brettdaman/ledstrip-night-lamp/electrics_wiring.jpg

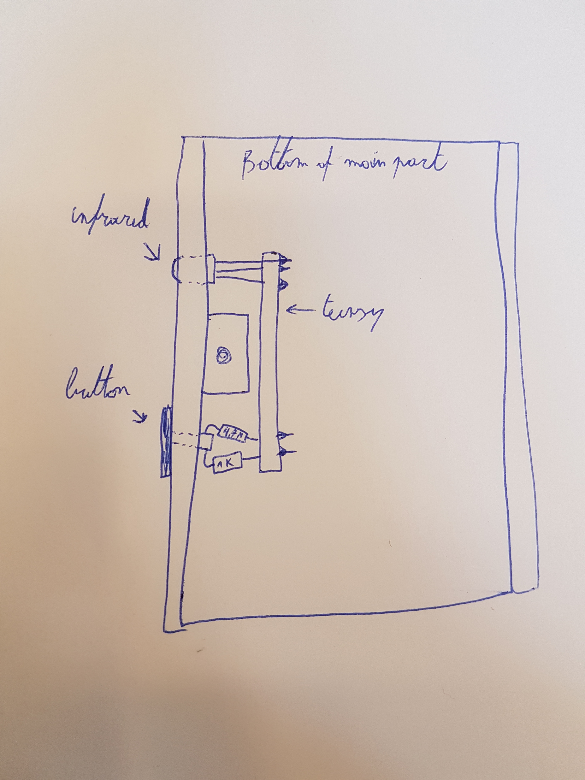
electrics_wiring.jpg
