brettdaman/ledstrip-night-lamp/(threads)

Thread 1 (2018-08-17):

Cant compile

Allram, 2018-08-17:
Hello,

Cant seem to get this to compile on Arduino IDE 1.8.5 Lots of errors on Fastled, and can't find FiniteMachineState.

Do you happend to know which libraries you used and which versions?

Allram, 2018-08-17:
Closing - Found the correct libs from Arduino Playground

Closed 2018-08-17.
